fwachsmuth/Clockwork/Clockwork-Documents/Projector_Photos/T610/film_13_T610-Microcomputer-Stereo_1695135457429.jpg

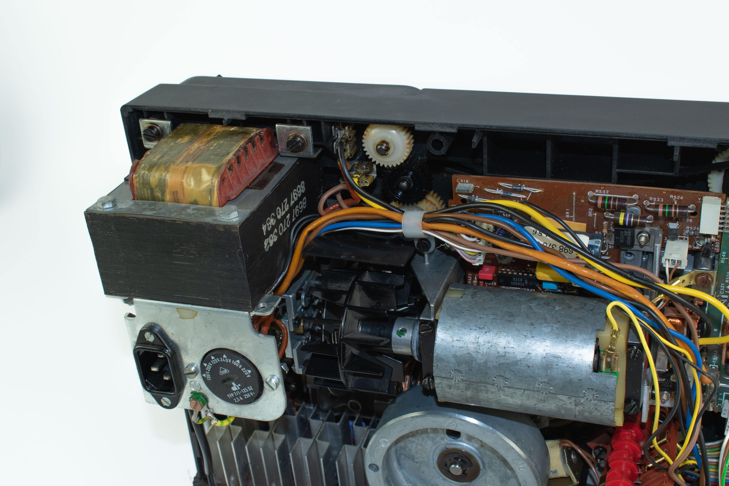
Clockwork-Documents/Projector_Photos/T610/film_13_T610-Microcomputer-Stereo_1695135457429.jpg
