fwachsmuth/Clockwork/Clockwork-Documents/Projector_Photos/T502/film_13_T502 Automatic Duoplay_1563969192064.jpg

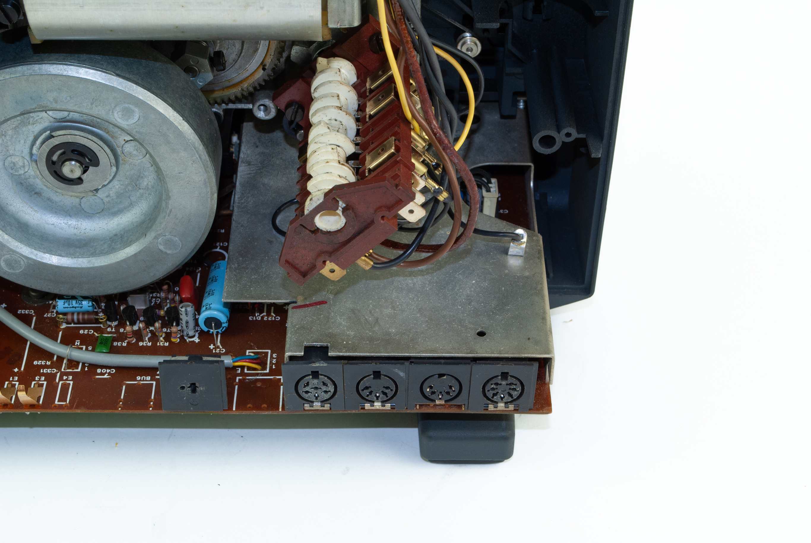
Clockwork-Documents/Projector_Photos/T502/film_13_T502 Automatic Duoplay_1563969192064.jpg
