fwachsmuth/Clockwork/Clockwork-Documents/Projector_Photos/T510/film_bauer_T510_1420456374245.jpg

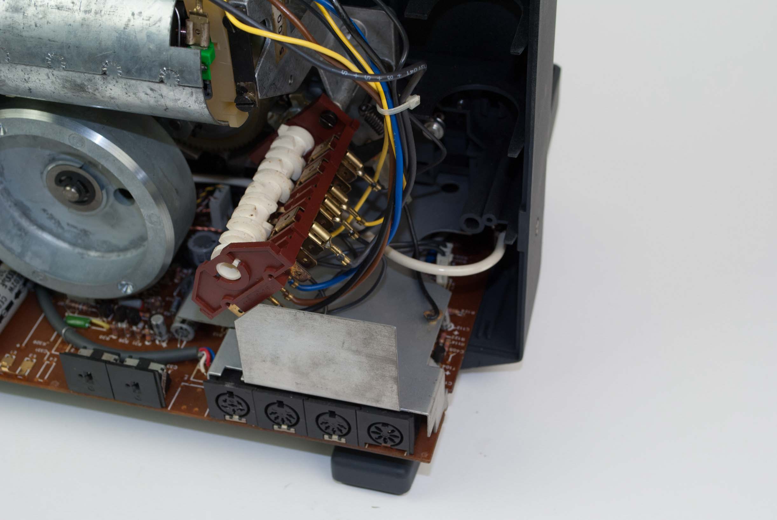
Clockwork-Documents/Projector_Photos/T510/film_bauer_T510_1420456374245.jpg
