fwachsmuth/Clockwork/KiCad/Clockwork-Controller/Clockwork-Controller.kicad_pcb

## KiCad design KiCad/Clockwork-Controller/Clockwork-Controller.kicad_pcb (2025-06-01)

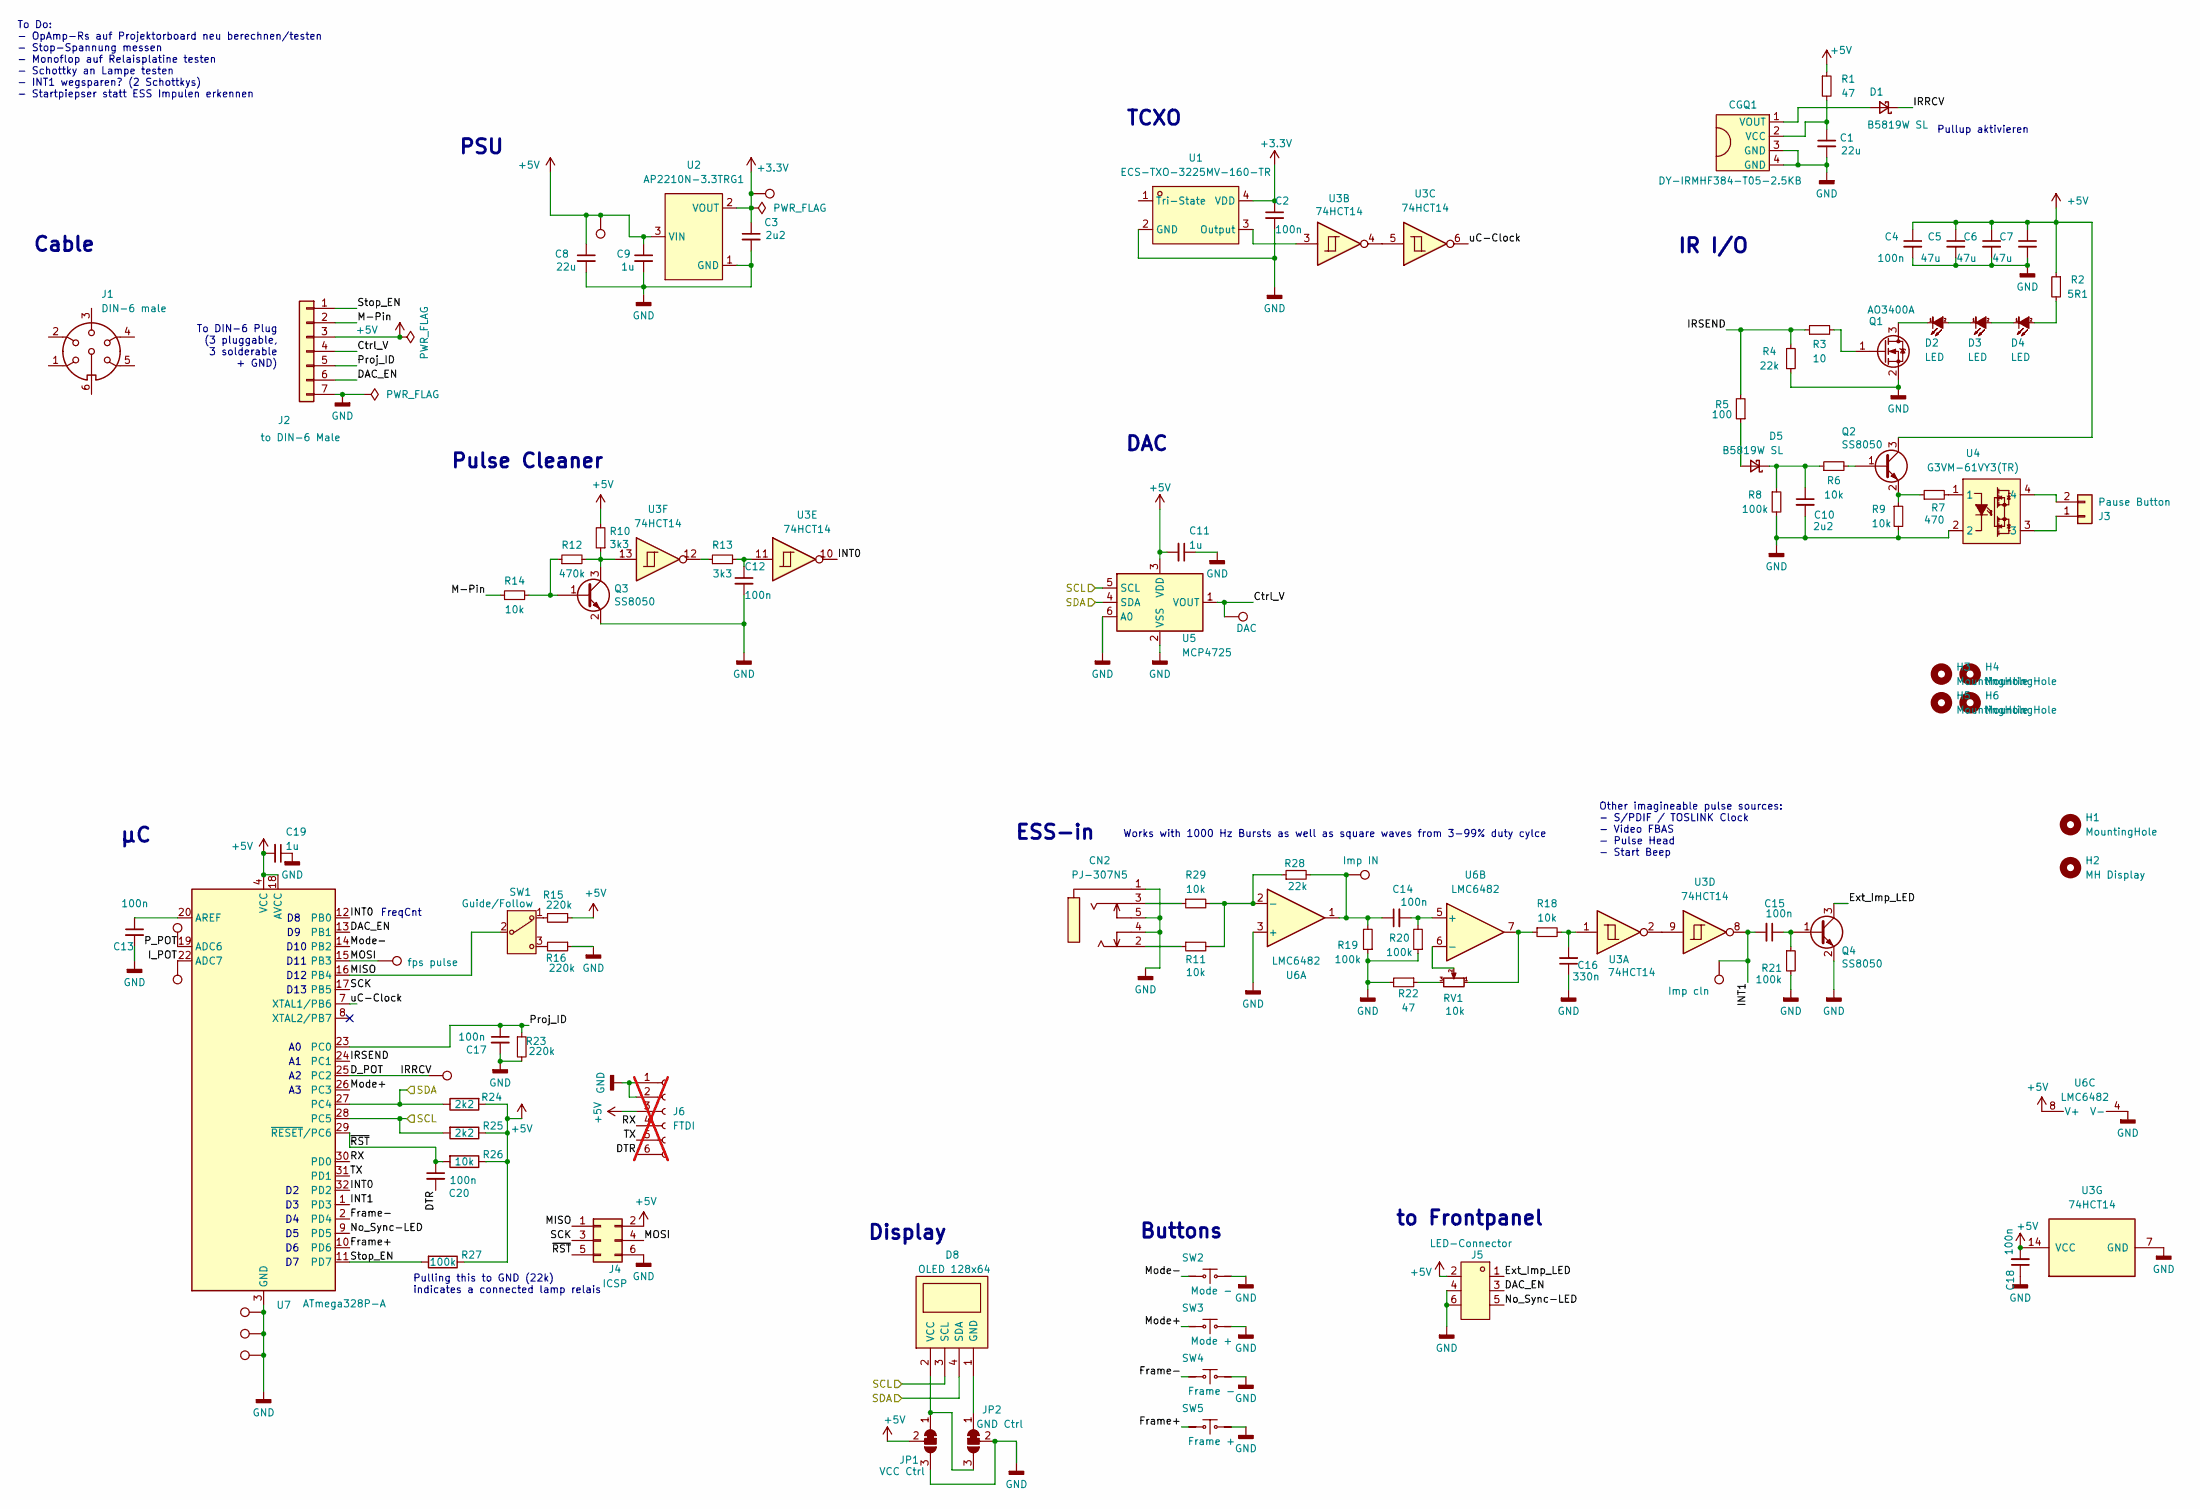
[picture p11: schematic Clockwork-Controller.kicad_sch, Clockwork Controller]

Parts:
C1, C8: 22u; C_0805_2012Metric; LCSC C45783
C2, C4, C12, C13, C14, C15, C17, C18, C20: 100n; C_0603_1608Metric; LCSC C14663
C3, C10: 2u2; C_0603_1608Metric; LCSC C23630
C5, C6, C7: 47u; C_1206_3216Metric; LCSC C15008
C9, C11, C19: 1u; C_0603_1608Metric; LCSC C15849
C16: 330n; C_0603_1608Metric; LCSC C1615
CGQ1: DY-IRMHF384-T05-2.5KB; OPTO-SMD_4P-L3.9-W3.4_IRM-H432M3-R8; LCSC Part C7280961
CN2: PJ-307N5; AUDIO-TH_PJ-307N5; LCSC Part C692542
D1, D5: B5819W SL; D_SOD-123; LCSC C8598
D2, D3, D4: LED; LED-SMD_XYC-IRA4335A65-X4; LCSC C2920776
D8: OLED 128x64; HDR-TH_4P-P2.54-V-F; LCSC C42163122
H1: MountingHole; Kabelbinder 4mm
H2: MH Display; MountingHole_2.2mm_M2_DIN965
H3, H4, H5, H6: MountingHole; MountingHole_3.2mm_M3_DIN965
J1: DIN-6 male
J2: to DIN-6 Male; CONN-TH_S7B-XH-A-LF-SN; LCSC C157916
J3: Pause Button; CONN-TH_2P-P2.54_MX128-2.54-GN01-02P-CU-Y-A; LCSC C918120
J4: ICSP; PinHeader_2x03_P2.54mm_Vertical_displaced
J5: LED-Connector; HDR-TH_6P-P2.00-V-F-R2-C3-S2.00-2; LCSC C7499367
J6: FTDI; PinHeader_1x06_P2.54mm_Vertical; not fitted
JP1: VCC Ctrl; SolderJumper-3_P1.3mm_Bridged2Bar12_RoundedPad1.0x1.5mm
JP2: GND Ctrl; SolderJumper-3_P1.3mm_Bridged2Bar12_RoundedPad1.0x1.5mm
Q1: AO3400A; SOT-23; LCSC C20917
Q2, Q3, Q4: SS8050; SOT-23; LCSC C2146
R1, R22: 47; R_0603_1608Metric; LCSC C23182
R2: 5R1; R_0805_2012Metric; LCSC C17724
R3: 10; R_0603_1608Metric; LCSC C22859
R4, R28: 22k; R_0603_1608Metric; LCSC C31850
R5: 100; R_0603_1608Metric; LCSC C22775
R6, R9, R11, R14, R18, R26, R29: 10k; R_0603_1608Metric; LCSC C25804
R7: 470; R_0603_1608Metric; LCSC C23179
R8, R19, R20, R21, R27: 100k; R_0603_1608Metric; LCSC C25803
R10, R13: 3k3; R_0603_1608Metric; LCSC C22978
R12: 470k; R_0603_1608Metric; LCSC C23178
R15, R16, R23: 220k; R_0603_1608Metric; LCSC C22961
R24, R25: 2k2; R_0603_1608Metric; LCSC C4190
RV1: 10k; RES-SMD_RK10J11R0A0H_fixed; LCSC C470766
SW1: Guide/Follow; SW-TH_SS-12D11G4R; LCSC C843370
SW2: Mode -; SW-SMD_4P-L6.0-W6.0-P4.50-LS9.0-H11.5; LCSC C455123
SW3: Mode +; SW-SMD_4P-L6.0-W6.0-P4.50-LS9.0-H11.5; LCSC C455123
SW4: Frame -; SW-SMD_4P-L6.0-W6.0-P4.50-LS9.0-H11.5; LCSC C455123
SW5: Frame +; SW-SMD_4P-L6.0-W6.0-P4.50-LS9.0-H11.5; LCSC C455123
TP1: 3V3; TestPoint_THTPad_1.5x1.5mm_Drill0.7mm
TP2: 5V; TestPoint_THTPad_1.5x1.5mm_Drill0.7mm
TP3, TP4, TP12: GND; TestPoint_THTPad_1.5x1.5mm_Drill0.7mm
TP5: DAC; TestPoint_THTPad_1.5x1.5mm_Drill0.7mm
TP6: P; TestPoint_THTPad_1.5x1.5mm_Drill0.7mm
TP7: I; TestPoint_THTPad_1.5x1.5mm_Drill0.7mm
TP8: fps pulse; TestPoint_THTPad_1.5x1.5mm_Drill0.7mm
TP9: Imp IN; TestPoint_THTPad_1.5x1.5mm_Drill0.7mm
TP10: Imp cln; TestPoint_THTPad_1.5x1.5mm_Drill0.7mm
TP11: D; TestPoint_THTPad_1.5x1.5mm_Drill0.7mm
U1: ECS-TXO-3225MV-160-TR; Crystal_SMD_3225-4Pin_3.2x2.5mm; LCSC C2442664
U2: AP2210N-3.3TRG1; SOT-23-3; LCSC Part C155508
U3: 74HCT14; TSSOP-14_4.4x5mm_P0.65mm; LCSC C5968
U4: G3VM-61VY3(TR); SOP-4_L3.9-W4.4-P2.54-LS7.0-BR; LCSC Part C2152318
U5: MCP4725; SOT-23-6; LCSC C144198
U6: LMC6482; SOIC-8_3.9x4.9mm_P1.27mm; LCSC C12620
U7: ATmega328P-A; TQFP-32_7x7mm_P0.8mm; LCSC C14877

Connections:
+3.3V: C2.1, C3.1, TP1.1, U1.4 (VDD), U2.2 (VOUT)
+5V: C4.1, C5.1, C6.1, C7.1, C8.1, C9.1, C11.2, C18.2, C19.2, J2.3, J4.2, J5.2, J6.3, JP1.2 (C), Q2.3 (C), R1.1, R2.1, R10.2, R15.1, R24.2, R25.1, R26.1, R27.1, TP2.1, U2.3 (VIN), U3.14 (VCC), U5.3 (VDD), U6.8 (V+), U7.4 (VCC), U7.6 (VCC), U7.18 (AVCC)
/Ctrl_V: J2.4, TP5.1, U5.1 (VOUT)
/DAC_EN: J2.6, J5.3, U7.13 (PB1)
/DTR: C20.2, J6.6
/D_POT: D1.1 (K), TP11.1, U7.25 (PC2)
/Ext_Imp_LED: J5.1, Q4.3 (C)
/Frame+: SW5.1, SW5.2, U7.10 (PD6)
/Frame-: SW4.1, SW4.2, U7.2 (PD4)
/INT0: U3.10, U7.12 (PB0), U7.32 (PD2)
/INT1: C15.2, TP10.1, U3.8, U7.1 (PD3)
/IRSEND: R3.1, R4.1, R5.2, U7.24 (PC1)
/I_POT: TP7.1, U7.22 (ADC7)
/M-Pin: J2.2, R14.1
/MISO: J4.1, SW1.2, U7.16 (PB4)
/MOSI: J4.4, TP8.1, U7.15 (PB3)
/Mode+: SW3.1, SW3.2, U7.26 (PC3)
/Mode-: SW2.1, SW2.2, U7.14 (PB2)
/No_Sync-LED: J5.5, U7.9 (PD5)
/P_POT: TP6.1, U7.19 (ADC6)
/Proj_ID: C17.1, J2.5, R23.1, U7.23 (PC0)
/RX: J6.4, U7.30 (PD0)
/SCK: J4.3, U7.17 (PB5)
/SCL: D8.3 (SCL), R25.2, U5.5 (SCL), U7.28 (PC5)
/SDA: D8.4 (SDA), R24.1, U5.4 (SDA), U7.27 (PC4)
/Stop_EN: J2.1, R27.2, U7.11 (PD7)
/TX: J6.5, U7.31 (PD1)
/uC-Clock: U3.6, U7.7 (XTAL1/PB6)
/~RST: C20.1, J4.5, R26.2, U7.29 (~RESET/PC6)
GND: C1.2, C2.2, C3.2, C4.2, C5.2, C6.2, C7.2, C8.2, C9.2, C10.2, C11.1, C12.2, C13.2, C16.1, C17.2, C18.1, C19.1, CGQ1.3 (GND), CGQ1.4 (GND), CN2.1, CN2.4, CN2.5, J2.7, J4.6, J5.4, J5.6, J6.1, J6.2, JP1.3 (B), JP2.2 (C), Q1.2 (S), Q3.2 (E), Q4.2 (E), R4.2, R8.2, R9.2, R16.1, R19.1, R20.1, R21.2, R22.2, R23.2, SW2.3, SW2.4, SW3.3, SW3.4, SW4.3, SW4.4, SW5.3, SW5.4, TP3.1, TP4.1, TP12.1, U1.2 (GND), U2.1 (GND), U3.7 (GND), U4.2, U5.2 (VSS), U5.6 (A0), U6.3 (+), U6.4 (V-), U7.3 (GND), U7.5 (GND), U7.21 (GND)
unnamed: C12.1, R13.2, U3.11
unnamed: C14.1, R19.2, R28.2, TP9.1, U6.1
unnamed: C16.2, R18.2, U3.1
unnamed: C1.1, CGQ1.2 (VCC), R1.2
unnamed: CGQ1.1 (VOUT), D1.2 (A)
unnamed: CN2.2, R11.1
unnamed: CN2.3, R29.1
unnamed: D2.2 (A), D3.1 (K)
unnamed: D2.1 (K), Q1.3 (D)
unnamed: D3.2 (A), D4.1 (K)
unnamed: D4.2 (A), R2.2
unnamed: D5.2 (A), R5.1
unnamed: C10.1, D5.1 (K), R6.1, R8.1
unnamed: D8.1 (GND), JP2.1 (A)
unnamed: D8.2 (VCC), JP1.1 (A), JP2.3 (B)
unnamed: J3.1, U4.3
unnamed: J3.2, U4.4
unnamed: Q1.1 (G), R3.2
unnamed: Q2.1 (B), R6.2
unnamed: Q2.2 (E), R7.1, R9.1
unnamed: Q3.1 (B), R12.1, R14.2
unnamed: Q3.3 (C), R10.1, R12.2, U3.13
unnamed: C15.1, Q4.1 (B), R21.1
unnamed: R7.2, U4.1
unnamed: R13.1, U3.12
unnamed: R15.2, SW1.1
unnamed: R16.2, SW1.3
unnamed: R18.1, RV1.1, U6.7
unnamed: R22.1, RV1.3
unnamed: U1.3 (Output), U3.3
unnamed: U3.2, U3.9
unnamed: U3.4, U3.5
unnamed: R11.2, R28.1, R29.2, U6.2 (-)
unnamed: C14.2, R20.2, U6.5 (+)
unnamed: RV1.2, U6.6 (-)
unnamed: C13.1, U7.20 (AREF)

Notes on the sheet:
D10
Pullup aktivieren
Display
Other imagineable pulse sources: - S/PDIF / TOSLINK Clock - Video FBAS - Pulse Head - Start Beep
D13
Buttons
to Frontpanel
Pulling this to GND (22k) indicates a connected lamp relais
To Do: - OpAmp-Rs auf Projektorboard neu berechnen/testen - Stop-Spannung messen - Monoflop auf Relaisplatine testen - Schottky an Lampe testen - INT1 wegsparen? (2 Schottkys) - Startpiepser statt ESS Impulen erkennen
Pulse Cleaner
Cable
D11
TCXO
DAC
Works with 1000 Hz Bursts as well as square waves from 3-99% duty cylce
FreqCnt
ESS-in
PSU
D12
To DIN-6 Plug (3 pluggable, 3 solderable + GND)
IR I/O

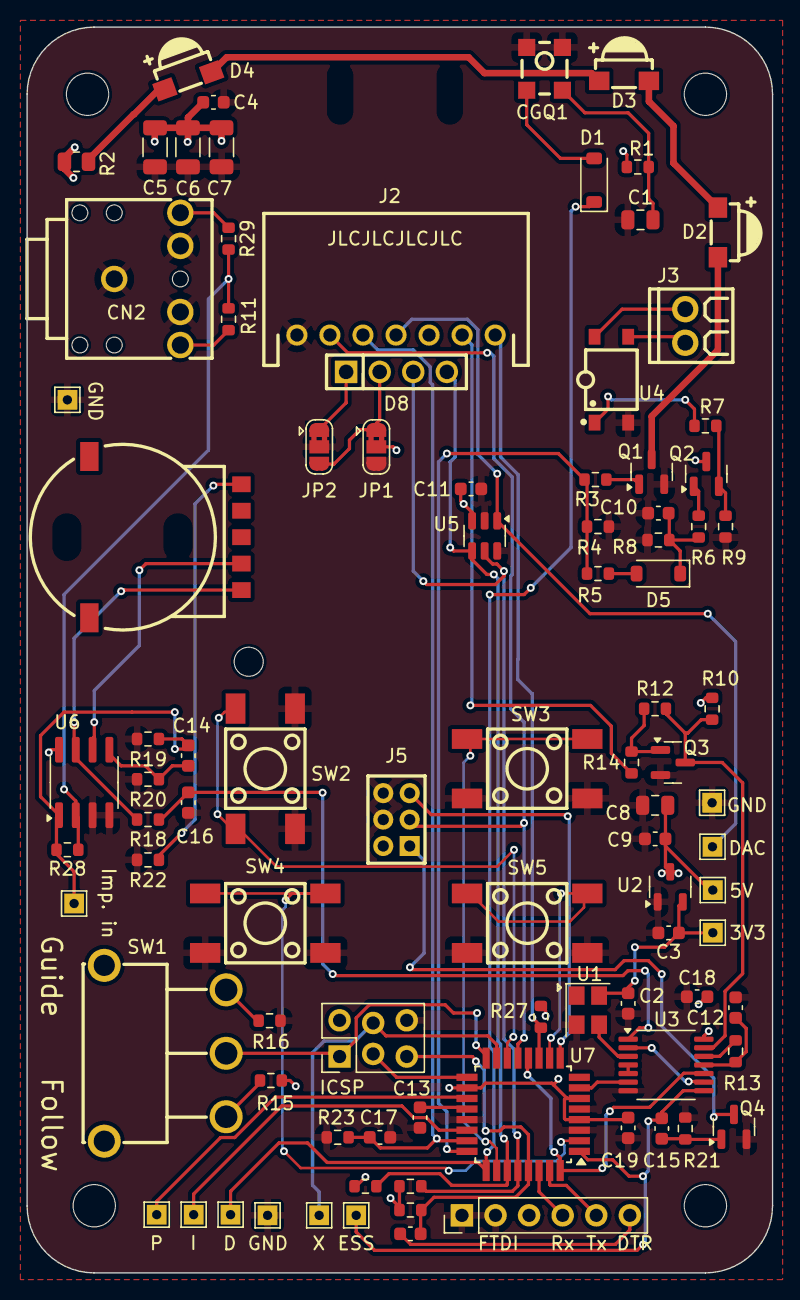
[picture p12: board Clockwork-Controller.kicad_pcb from above]

Board: 2 copper layers, 56.4 x 94.2 mm, 98 parts (0 on the bottom side), 66 nets.
