fwachsmuth/Clockwork/KiCad/Clockwork-ProjectorBoard/Clockwork-ProjectorBoard.kicad_pcb

## KiCad design KiCad/Clockwork-ProjectorBoard/Clockwork-ProjectorBoard.kicad_pcb (2025-05-31)

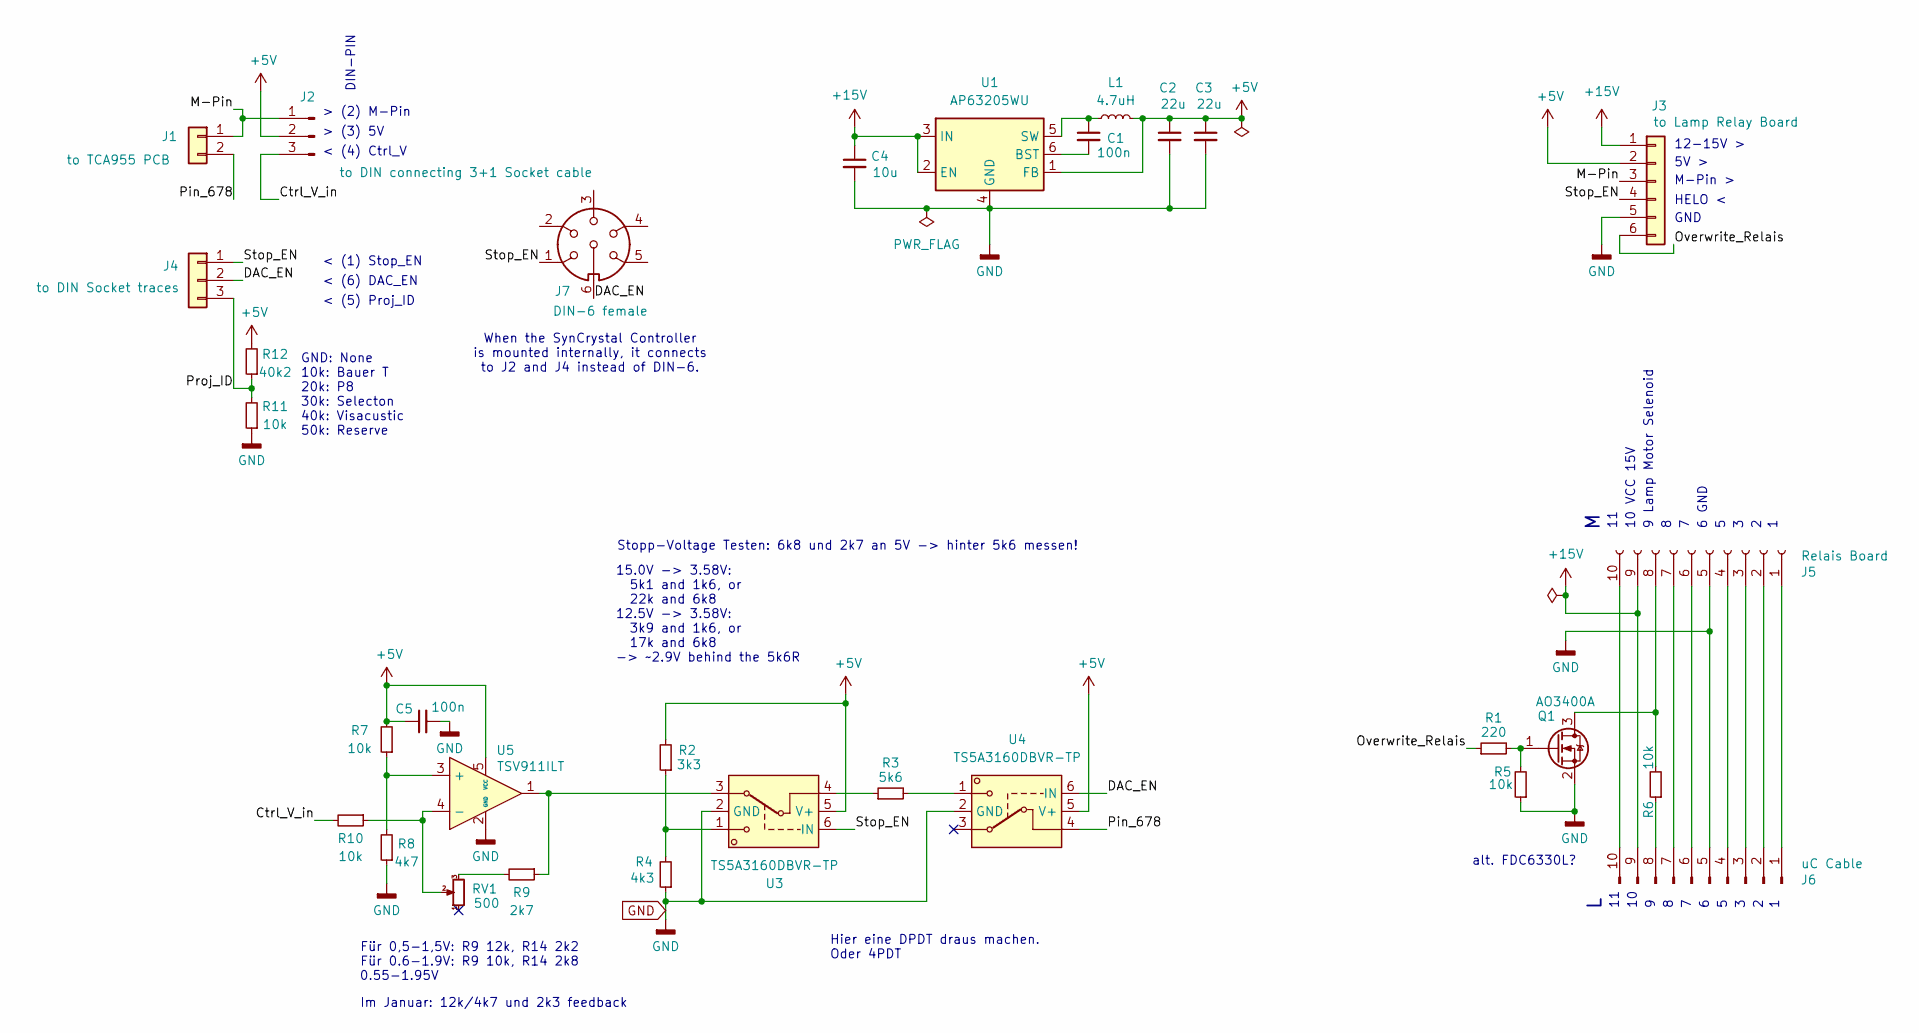
[picture p13: schematic Clockwork-ProjectorBoard.kicad_sch, Clockwork Projector Board T610/T525]

Parts:
C1, C5: 100n; C_0603_1608Metric; LCSC C14663
C2, C3: 22u; C_0603_1608Metric; LCSC C45783
C4: 10u; C_0603_1608Metric; LCSC C15850
J1: to TCA955 PCB; CONN-TH_2P-P2.54_ZX-XH2.54-2PZZ-Y; LCSC C22388684
J2: to DIN connecting 3+1 Socket cable; PinHeader_1x03_P2.54mm_Vertical_BAUER; LCSC C6332196
J3: to Lamp Relay Board; CONN-TH_6P-P2.54_ZX-XH2.54-6PZZ-R; LCSC C22388628
J4: to DIN Socket traces; CONN-TH_ZX-XH2.54-3PZZ-Y; LCSC C22388685
J5: Relais Board; HDR-TH_10P-P2.54-H-F-W10.0-N; LCSC C2897392
J6: uC Cable; HDR-TH_10P-P2.54-H-M-W10.4_flipped; LCSC C3012231
J7: DIN-6 female
L1: 4.7uH; IND-SMD_L3.0-W3.0; LCSC C527613
Q1: AO3400A; SOT-23; LCSC C20917
R1: 220; R_0603_1608Metric; LCSC C22962
R2: 3k3; R_0603_1608Metric
R3: 5k6; R_0603_1608Metric; LCSC C23189
R4: 4k3; R_0603_1608Metric
R5, R6, R7, R10: 10k; R_0603_1608Metric; LCSC C25804
R8: 4k7; R_0603_1608Metric; LCSC C23162
R9: 2k7; R_0603_1608Metric; LCSC C13167
R11: 10k; R_0402_1005Metric; LCSC C25744
R12: 40k2; R_0402_1005Metric; LCSC C137983
RV1: 500; RES-ADJ-SMD_3P-L3.8-W3.7_VGF39NCHXT; LCSC C720649
U1: AP63205WU; TSOT-23-6; LCSC C2071056
U3, U4: TS5A3160DBVR-TP; SOT-23-6_L2.9-W1.6-P0.95-LS2.8-BR; LCSC C42411033
U5: TSV911ILT; SOT-23-5_L2.9-W1.6-P0.95-LS2.8-BR; LCSC C672321

Connections:
+5V: C2.1, C3.1, C5.1, J2.2, J3.2, L1.2, R2.2, R7.2, R12.2, U1.1 (FB), U3.5 (V+), U4.5 (V+), U5.5 (VCC)
+15V: C4.1, J3.1, J5.9, J6.9, U1.2 (EN), U1.3 (IN)
/Ctrl_V_in: J2.3, R10.2
/DAC_EN: J4.2, J7.6, U4.6 (IN)
/M-Pin: J1.1, J2.1, J3.3
/Overwrite_Relais: J3.6, R1.1
/Pin_678: J1.2, U4.4
/Proj_ID: J4.3, R11.2, R12.1
/Stop_EN: J3.4, J4.1, J7.1, U3.6 (IN)
GND: C2.2, C3.2, C4.2, C5.2, J3.5, J5.5, J6.5, Q1.2 (S), R4.1, R5.1, R8.1, R11.1, U1.4 (GND), U3.2 (GND), U4.2 (GND), U5.2 (GND)
unnamed: J5.1, J6.1
unnamed: J5.2, J6.2
unnamed: J5.3, J6.3
unnamed: J5.4, J6.4
unnamed: J5.6, J6.6
unnamed: J5.7, J6.7
unnamed: J5.8, Q1.3 (D), R6.2
unnamed: J5.10, J6.10
unnamed: J6.8, R6.1
unnamed: Q1.1 (G), R1.2, R5.2
unnamed: R2.1, R4.2, U3.1
unnamed: R3.1, U3.4
unnamed: R3.2, U4.1
unnamed: R9.1, U3.3, U5.1
unnamed: R9.2, RV1.3
unnamed: C1.2, U1.6 (BST)
unnamed: C1.1, L1.1, U1.5 (SW)
unnamed: R7.1, R8.2, U5.3 (+)
unnamed: R10.1, RV1.2, U5.4 (-)

Notes on the sheet:
Hier eine DPDT draus machen. Oder 4PDT
5V >
0.55-1.95V
M-Pin >
Für 0,5-1,5V: R9 12k, R14 2k2 Für 0.6-1.9V: R9 10k, R14 2k8
HELO <
When the SynCrystal Controller is mounted internally, it connects to J2 and J4 instead of DIN-6.
6 GND
> (3) 5V
< (6) DAC_EN
Im Januar: 12k/4k7 und 2k3 feedback
> (2) M-Pin
DIN-PIN
GND: None 10k: Bauer T 20k: P8 30k: Selecton 40k: Visacustic 50k: Reserve
10 VCC 15V
< (5) Proj_ID
alt. FDC6330L?
< (4) Ctrl_V
15.0V -> 3.58V: 5k1 and 1k6, or 22k and 6k8 12.5V -> 3.58V: 3k9 and 1k6, or 17k and 6k8 -> ~2.9V behind the 5k6R
< (1) Stop_EN
GND
12-15V >
9 Lamp Motor Selenoid
Stopp-Voltage Testen: 6k8 und 2k7 an 5V -> hinter 5k6 messen!

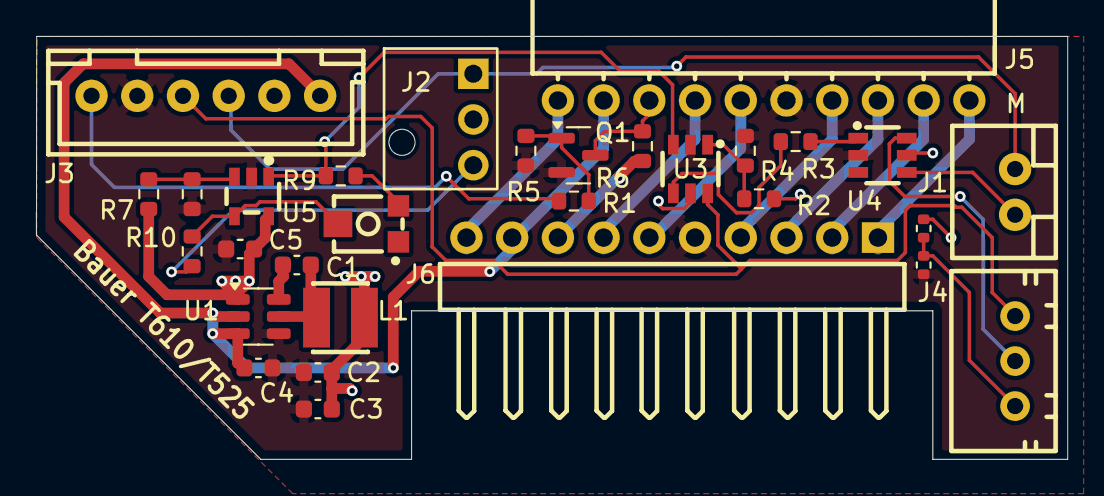
[picture p14: board Clockwork-ProjectorBoard.kicad_pcb from above]

Board: 2 copper layers, 57.3 x 23.5 mm, 30 parts (0 on the bottom side), 29 nets.
