fwachsmuth/Clockwork/KiCad/Clockwork-Frontpanel/Clockwork-Frontpanel.kicad_pcb

## KiCad design KiCad/Clockwork-Frontpanel/Clockwork-Frontpanel.kicad_pcb (2025-05-29)

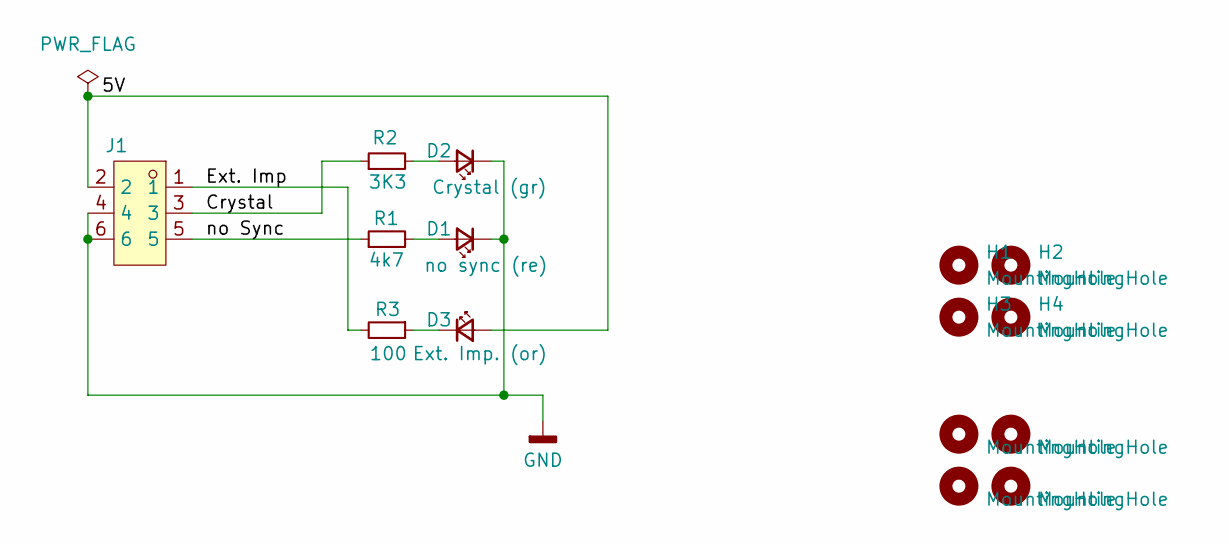
[picture p15: schematic Clockwork-Frontpanel.kicad_sch]

Parts:
D1: no sync (re); LED-SMD_L3.2-W1.6-RD-EH-3_kicad; LCSC C2892757
D2: Crystal (gr); LED-SMD_L3.2-W1.6-RD-EH-3_kicad; LCSC C2980185
D3: Ext. Imp. (or); LED-SMD_L3.2-W1.6-RD-EH-3_kicad; LCSC C424133
H1, H2, H3, H4: MountingHole; MountingHole_3.2mm_M3_DIN965
H5, H6, H7, H8: MountingHole; MountingHole_3.5mm_M3
J1: HDR-SMD_6P-P2.00-V-M-R2-C3-LS6.5_flipped; LCSC Part C3294482
R1: 4k7; R_0603_1608Metric
R2: 3K3; R_0603_1608Metric; LCSC C22978
R3: 100; R_0603_1608Metric

Connections:
/5V: D3.2 (A), J1.2
/Crystal: J1.3, R2.1
/Ext. Imp: J1.1, R3.2
/no Sync: J1.5, R1.1
GND: D1.1 (K), D2.1 (K), J1.4, J1.6
unnamed: D1.2 (A), R1.2
unnamed: D2.2 (A), R2.2
unnamed: D3.1 (K), R3.1

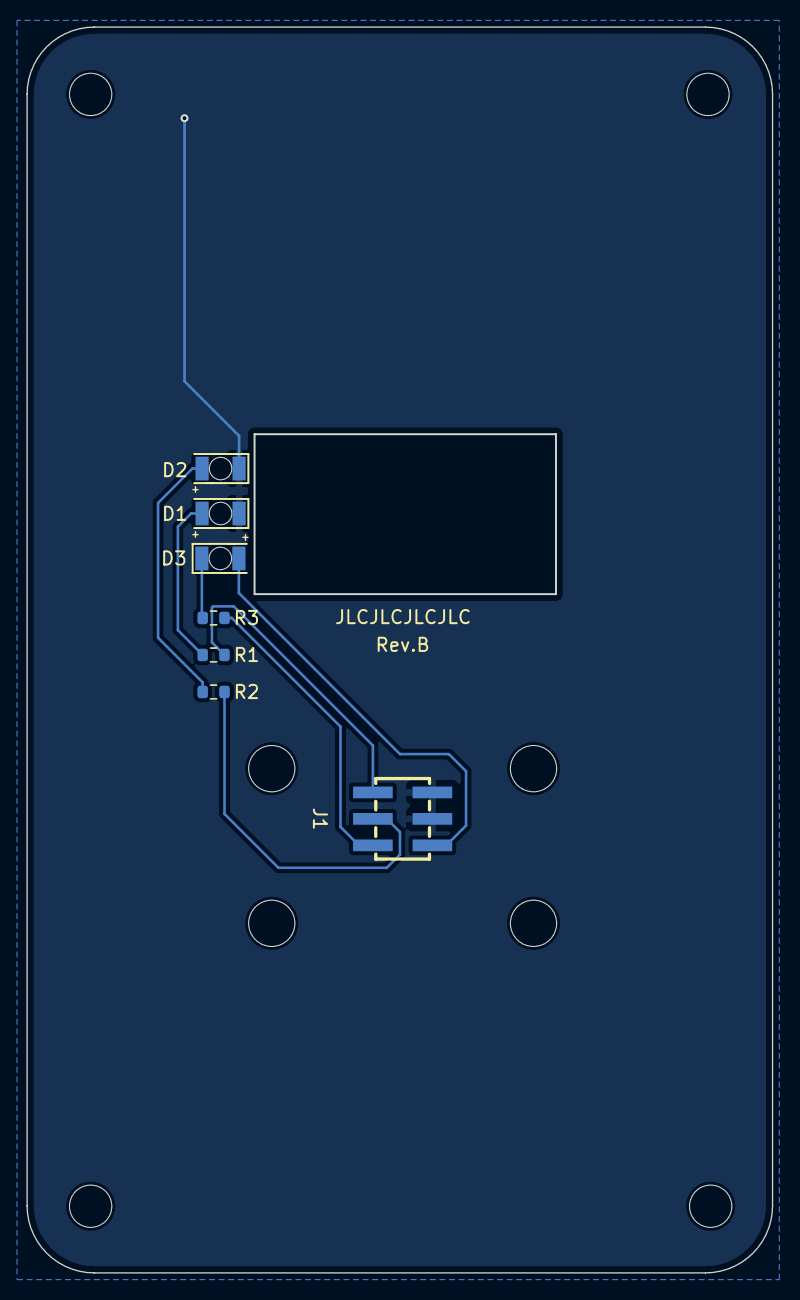
[picture p16: board Clockwork-Frontpanel.kicad_pcb from below]

Board: 2 copper layers, 56.4 x 94.2 mm, 15 parts (7 on the bottom side), 8 nets.
