fwachsmuth/Clockwork/(commit log)

2019-11-17 First Button attempt
2019-11-17 Better Button Handling
2019-11-24 Adding Switch Library from Nick Gammon
2024-12-21 Initial KiCad thoughts
    [SynCrystal-kicad.kicad_pcb, SynCrystal-kicad.kicad_sch]
2024-12-24 speed reliable detected 8 frames after projector start...
2024-12-24 Better: 48 frames to determine speed :)
2024-12-24 use insertion sort instead of qsort — saves 950B of program storage and should also be faster with just 12 items
2024-12-27 using Timer2 instead of micros()
2024-12-28 the opamp
    [SynCrystal-kicad.kicad_sch]
2024-12-28 a wonderfully working PID controller, roughly tuned
2024-12-29 stop measuring running freq once we have found a switch pos (until the projector stops)
2024-12-29 fixes initing the PID with initial values both on start as well as inbetween projector runs
2024-12-29 fixes overshooting on subsequent projector runs due to false PID computations in a race condition (shaft stil breaking timer fired already before stop detection)
2024-12-29 Let's add some buttons
    [SynCrystal-kicad.kicad_sch]
2024-12-29 adds push buttons, starts measuring DAC value lifetime
    [SynCrystal-kicad.kicad_sch]
2024-12-30 PID is running more often (Nyquist) but less aggressive for a smootehr run. Consider a two-stage PID later.
2024-12-30 Removing all the EPROM Foo. All we need is a faster (or adaptive) PID.
2024-12-30 added a switch to pin 9 to connect/disconnect the overlay voltage
2024-12-30 adding switch to kicad
    [SynCrystal-kicad.kicad_sch]
2024-12-31 Partila Button handling, but this ancient SwitchManager is coming to its limits...
2025-01-01 Correct Button handling, yay
2025-01-01 4 Buttons is so much better than just two. Longpresses are just not intuitive.
2025-01-01 Adds support to catch-up / drop-back a frame or three
2025-01-02 Timer1 wip
2025-01-02 dithering timers to wuthering heights
2025-01-02 refined timer configs
2025-01-03 Speed Lock LED; this wil go on the display tho
2025-01-04 First FreqMeasure-based run detection, still freewheeling though — second start is hence measuered wrong.
    [SynCrystal-kicad.kicad_sch]
2025-01-04 adding a button helper
2025-01-04 prep work for sepmag-comaptible speed switching
2025-01-05 wip, but fixed some VERY nasty bugs where pulse and frames were mixed up
2025-01-05 Biggest bug fixed — nned to put the timer_factor into the timer ISR to count pulses correctly
2025-01-05 It (mostly) works again. I have no idea though why resetting the timer_modulus in the SetupTimer1forFps() caused that the modulus never incremented beyond 1 in the timer ISR.
2025-01-05 Fixes the lag on start by passing on the freqMeasured frames as timer_pulses offset. Also removed the "both ISR updated" sempahores since the made a lot of headaches
2025-01-06 initial adaptive pid... crazy
2025-01-06 PID-Kontrolle per Poti :)
2025-01-06 PID is perfectly tuned, added code for re-tuning with pots if needed
2025-01-06 We are setting the altered timer_pulse values now. Can't really confirm yet if controller keeps sync (need SMPTE timecode to verify.) However, pending errors somehow seem to add up?
2025-01-11 timer_corection_factor calculation finally precise AND working
2025-01-11 add scope test pin on d7
    [SynCrystal-kicad.kicad_sch]
2025-01-11 Refactored timer1 setup
2025-01-14 Skip Auto Mode when the projector is running — it makes no sense.
2025-01-19 pulling the schamtice together
    [SynCrystal-kicad.kicad_sch]
2025-01-20 Schematics Progress
    [SynCrystal-kicad.kicad_sch]
2025-01-20 ERC progress
    [SynCrystal-kicad.kicad_sch]
2025-01-20 ERC clean, some pin changes for final PCB
    [SynCrystal-kicad.kicad_sch]
2025-01-20 Most footprints
    [SynCrystal-kicad.kicad_sch]
2025-01-23 PCB in progress
    [SynCrystal-kicad.kicad_pcb, SynCrystal-kicad.kicad_sch]
2025-01-25 More Footprint work
    [SynCrystal-kicad.kicad_pcb, SynCrystal-kicad.kicad_sch]
2025-02-01 More schematics
    [DAC.kicad_sch, ESS_in.kicad_sch, Frontpanel.kicad_sch, PSU.kicad_sch, Proj_Imp_Cleanup.kicad_sch, Projector_PCB.kicad_sch, SynCrystal-kicad.kicad_pcb, SynCrystal-kicad.kicad_sch]
2025-02-02 Projector PCB!
    [DAC.kicad_sch, ESS_in.kicad_sch, Frontpanel.kicad_sch, PSU.kicad_sch, Proj_Imp_Cleanup.kicad_sch, Projector_PCB.kicad_sch, SynCrystal-kicad.kicad_sch, SynCrystal_LampRelais.kicad_pcb]
2025-02-03 DRC for Projector Board happy
    [SynCrystal_ProjectorBoard.kicad_pcb, SynCrystal_ProjectorBoard.kicad_sch]
2025-02-04 Polishing up for Rev.A
    [SynCrystal_ProjectorBoard.kicad_pcb]
2025-02-09 More changes
    [Frontpanel.kicad_sch, GuideStart.kicad_sch, SynCrystal-kicad.kicad_sch, SynCrystal_ProjectorBoard.kicad_pcb, SynCrystal_ProjectorBoard.kicad_sch]
2025-03-02 Starting to assign part numbers
    [DAC.kicad_sch, PSU.kicad_sch, Proj_Imp_Cleanup.kicad_sch, SynCrystal-kicad.kicad_sch, SynCrystal_FrontPanel.kicad_pcb, SynCrystal_FrontPanel.kicad_sch, SynCrystal_ProjectorBoard.kicad_sch, tcxo.kicad_sch]
2025-03-05 Adding the OpAmp to the Projector Board, also, some LCSC Part numbers
    [SynCrystal_ProjectorBoard.kicad_sch]
2025-03-07 Moved the OpAmp to the Projector Board. This Layout is DRC 0, but not optimal
    [SynCrystal-kicad.kicad_sch, SynCrystal_ProjectorBoard.kicad_pcb, SynCrystal_ProjectorBoard.kicad_sch]
2025-03-07 Much better layout, DRC = 0
    [SynCrystal_ProjectorBoard.kicad_pcb]
2025-03-10 moving the 10k OpAmp Input R to the Projector board
    [SynCrystal-kicad.kicad_sch, SynCrystal_ProjectorBoard.kicad_pcb, SynCrystal_ProjectorBoard.kicad_sch]
2025-03-14 Adding the VOltage Divider to Projector Board to allow Projector Detection. Also, fixing various footprints on the controller. ERC now failing.
    [SynCrystal-kicad.kicad_pcb, SynCrystal-kicad.kicad_sch, SynCrystal_ProjectorBoard.kicad_pcb, SynCrystal_ProjectorBoard.kicad_sch]
2025-03-15 ERC now happy!
    [SynCrystal-kicad.kicad_pcb, SynCrystal-kicad.kicad_sch]
2025-03-15 Reannotated, PCB now messed up :)
    [SynCrystal-kicad.kicad_sch]
2025-03-16 90% routed
    [SynCrystal-kicad.kicad_pcb, SynCrystal-kicad.kicad_sch]
2025-03-16 Looking good! Stil gotta run DRC
    [SynCrystal-kicad.kicad_pcb, SynCrystal-kicad.kicad_sch]
2025-03-16 DRC happy, me happy.
    [SynCrystal-kicad.kicad_pcb, SynCrystal-kicad.kicad_sch]
2025-03-24 Rev.A, orderable
    [SynCrystal-kicad.kicad_pcb, SynCrystal-kicad.kicad_sch]
2025-03-24 Renaming Project and Repo from "SynCrystal" to "ImpulsWerk"
    [DAC.kicad_sch, ESS_in.kicad_sch, Frontpanel.kicad_sch, GuideStart.kicad_sch, ImpulsWerk-Controller.kicad_pcb, ImpulsWerk-Controller.kicad_sch, ImpulsWerk-Frontpanel.kicad_pcb, ImpulsWerk-Frontpanel.kicad_sch]
2025-03-31 Before renaming
    [ImpulsWerk-Controller.kicad_pcb, ImpulsWerk-Controller.kicad_sch, ImpulsWerk-Frontpanel.kicad_pcb, ImpulsWerk-Frontpanel.kicad_sch]
2025-04-02 Renaming once more
    [Clockwork-Controller.kicad_pcb, Clockwork-Controller.kicad_sch, Clockwork-Frontpanel.kicad_pcb, Clockwork-Frontpanel.kicad_sch, Clockwork-LampRelais.kicad_pcb, Clockwork-LampRelais.kicad_sch, Clockwork-ProjectorBoard.kicad_pcb, Clockwork-ProjectorBoard.kicad_sch]
2025-04-07 New Gerbers, added the xtal to the BOM, new MH for OLED
    [Clockwork-Controller.kicad_pcb, Clockwork-Controller.kicad_sch, Clockwork-Frontpanel.kicad_pcb, Clockwork-Frontpanel.kicad_sch, Clockwork-ProjectorBoard.kicad_pcb, Clockwork-ProjectorBoard.kicad_sch]
2025-05-18 Starting Rev.B, fixing DIN-Connector-Wire Pin 2/3 to keep DIN/JST pin alignment
    [Clockwork-ProjectorBoard.kicad_pcb, Clockwork-ProjectorBoard.kicad_sch]
2025-05-28 Removing redundant R11, pulling M Pin up before reaching the Schmitt Triggers
    [Clockwork-Controller.kicad_pcb, Clockwork-Controller.kicad_sch]
2025-05-28 Updating some Pins for PCB
2025-05-29 Swao Ext.Imp and Sync LED
    [Clockwork-Controller.kicad_pcb, Clockwork-Controller.kicad_sch]
2025-05-29 Adding GND TPs
    [Clockwork-Controller.kicad_pcb, Clockwork-Controller.kicad_sch]
2025-05-29 Lowered J2 further towards the display to allow better cable securing
    [Clockwork-Controller.kicad_pcb]
2025-05-29 Enlarging wirestrap holes (4mm)
    [Clockwork-Controller.kicad_pcb]
2025-05-29 Updating BOM to use C455123 switches (11.5mm, not 8mm)
    [Clockwork-Controller.kicad_pcb]
2025-05-29 Moving the 3.5mm jack inwards to be flush with the edge
    [Clockwork-Controller.kicad_pcb, Clockwork-Controller.kicad_sch]
2025-05-29 Enlarged J3 holes per JLC request (1.2mm)
    [Clockwork-Controller.kicad_pcb]
2025-05-29 Adding FTDI port
    [Clockwork-Controller.kicad_pcb, Clockwork-Controller.kicad_sch]
2025-05-29 Label it Rev.B
    [Clockwork-Controller.kicad_pcb]
2025-05-29 Swapping IR Tx and Rx for better reach
    [Clockwork-Controller.kicad_pcb]
2025-05-29 Fixing the Pin Numbering Mess for the Frontpanel LEDs, also, polarity of ESS in LED
    [Clockwork-Frontpanel.kicad_pcb, Clockwork-Frontpanel.kicad_sch]
2025-05-29 Enable Rev.B also for the Forntpanel
    [Clockwork-Frontpanel.kicad_pcb]
2025-05-29 Updated Resistor Values, Button Holes 0.3mm bigger, Display Rect 1mm lower, new LED Labels, Moved GND Via
    [Clockwork-Frontpanel.kicad_pcb, Clockwork-Frontpanel.kicad_sch]
2025-05-29 Adjusting LED-Pins on the Controller Side (adding VCC)
    [Clockwork-Controller.kicad_pcb, Clockwork-Controller.kicad_sch, Clockwork-Frontpanel.kicad_pcb]
2025-05-29 Potentiometer Flip for more intuitive Pulse Amp control
    [Clockwork-Controller.kicad_pcb, Clockwork-Controller.kicad_sch]
2025-05-29 Starting to make the Projector detections working. STOP_EN does not work as input tho due to the pulldown on the MOSFET. Maybe DAC_EN is an option when in Input mode?
    [Clockwork.ino]
2025-05-30 Adds temp code to enable STOP_EN_PIN after 15 seconds. Also, it disables the Pin 7 toggling that was still in the ISR for debug...
2025-05-30 Fixes the Voltage Divider for the STOP Voltage, which turned out too low
    [Clockwork-ProjectorBoard.kicad_pcb, Clockwork-ProjectorBoard.kicad_sch]
2025-05-31 Adding a 6th Pin to the Lamp Relais Connector, which pulls the MOSFET high, disabling the built-in Relay
    [Clockwork-ProjectorBoard.kicad_pcb, Clockwork-ProjectorBoard.kicad_sch]
2025-05-31 Optimize Projector Board Size, red socket will fit better.
    [Clockwork-ProjectorBoard.kicad_pcb, Clockwork-ProjectorBoard.kicad_sch]
2025-05-31 Optimized THT pad diameters for the connectors
    [Clockwork-ProjectorBoard.kicad_pcb]
2025-05-31 Adding the 6th pin to the Lamp Relay Schematic
    [Clockwork-LampRelais.kicad_sch, Clockwork-ProjectorBoard.kicad_sch]
2025-05-31 On Startup, detect if a Lamp Rela Board is connected or not
2025-06-01 Using both left and right channel for ESS in
    [Clockwork-Controller.kicad_pcb, Clockwork-Controller.kicad_sch]
2025-06-01 Properly summing up R and L channel using the second OpAmp
    [Clockwork-Controller.kicad_pcb, Clockwork-Controller.kicad_sch]
2025-06-01 Set PID tuning based on projector's struct
2025-06-01 Read and set the projector's correct DAC init values for the nextspeed
    [Clockwork.ino]
2025-06-01 Introduce DAC init values for both 18 and 24 switchpos and use them as fit
2025-06-04 Fixing the odd "skip modes while running" bug and the terrible if-redundancy. Also, introducing small font, saves ~4K. Not sure yet if better
    [Clockwork.ino]
2025-06-05 Implements better speed mode switching — no more memcopy of bullshit values.
2025-06-11 Decouple SpeedModes and SpeedConfigs (not all Modes have/need a timer1 config)
